ryoono/ding_dong_flash/data/システムモデル.pptx

インターホン子機

インターホン親機

デバイス親機

デバイス子機3

玄関

LED

LED

物理線

ブザー

無線

デバイス子機2

LED

LED

デバイス

デバイス子機1

LED

キッチン

ブザー

間取り

## Slide 2

ピンポンフラッシュ

デバイス子機1
(192.168.1.2)

鳴動処理

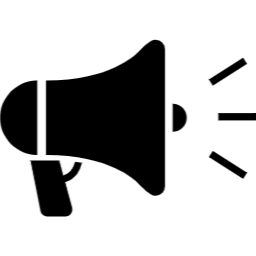
[picture p7: figure]

ブザー

LED

点灯リクエスト

点灯処理

インターホン親機

デバイス親機
(192.168.1.1)

点灯処理

デバイス子機2
(192.168.1.3)

点灯処理

LED

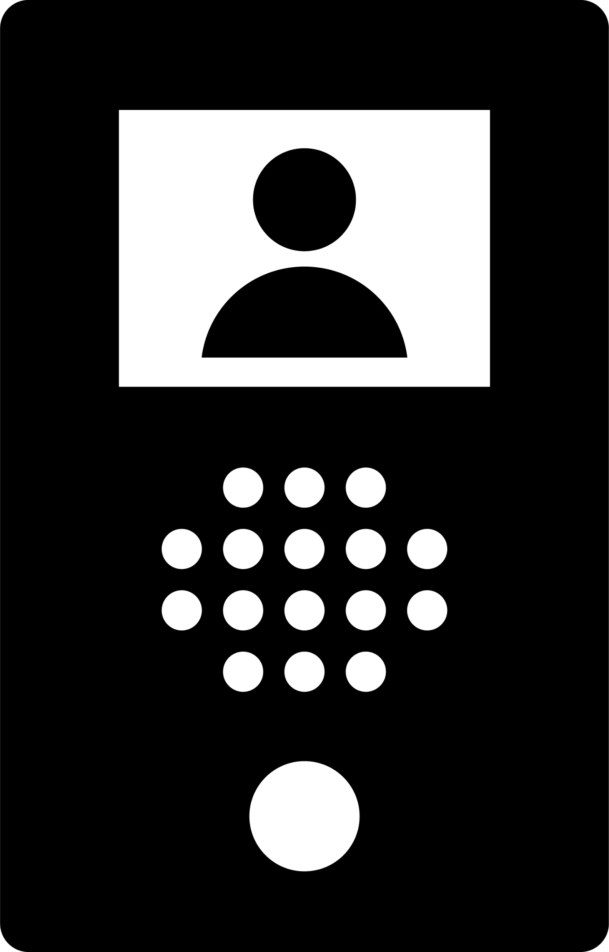
[picture p8: figure]

LED

インターホン子機
押下時にON

インターホン子機
押下判定

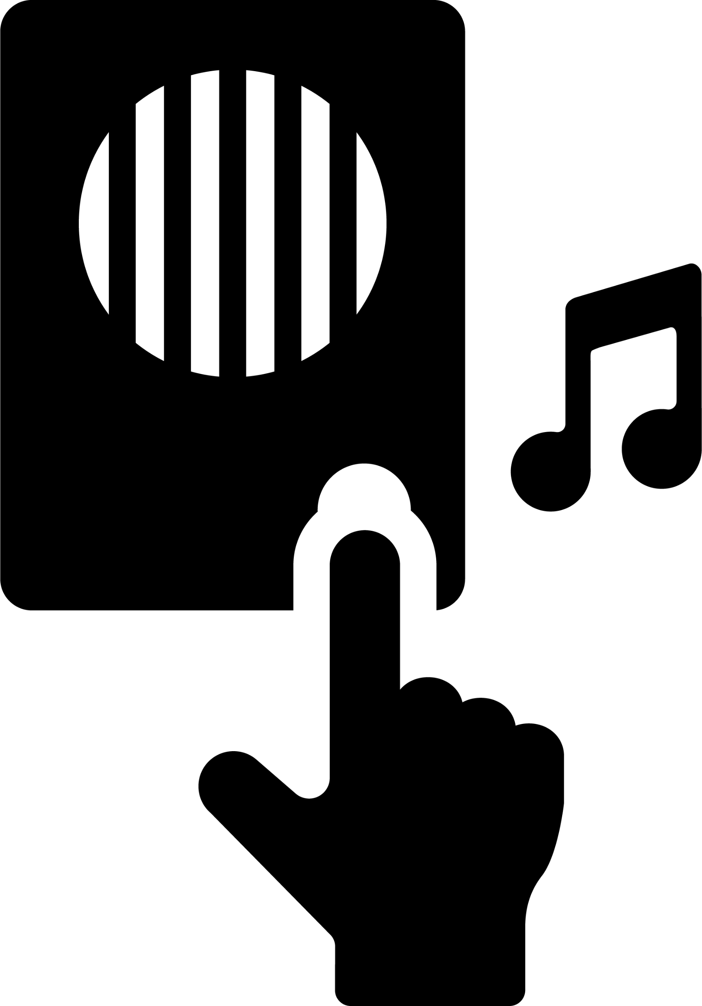
[picture p9: figure]

デバイス子機3
(192.168.1.4)

点灯処理

物理線

LED

インターホン子機

無線
