ryoono/ding_dong_flash/data/実態配線図.png

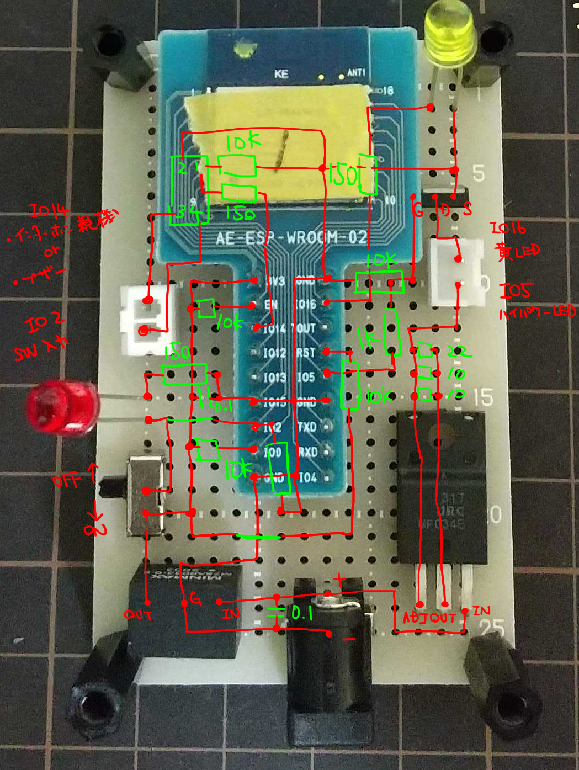
data/実態配線図.png
