ryoono/ding_dong_flash/instruction_manual/ピンポンフラッシュ取扱説明書.docx

ピンポンフラッシュ取扱説明書

# 仕様

本システムは来客を光で通知するシステムであり、インターホン押下のタイミングで一定の間、

ハイパワーLEDを点滅させる。以下の配置で設置することを想定している。

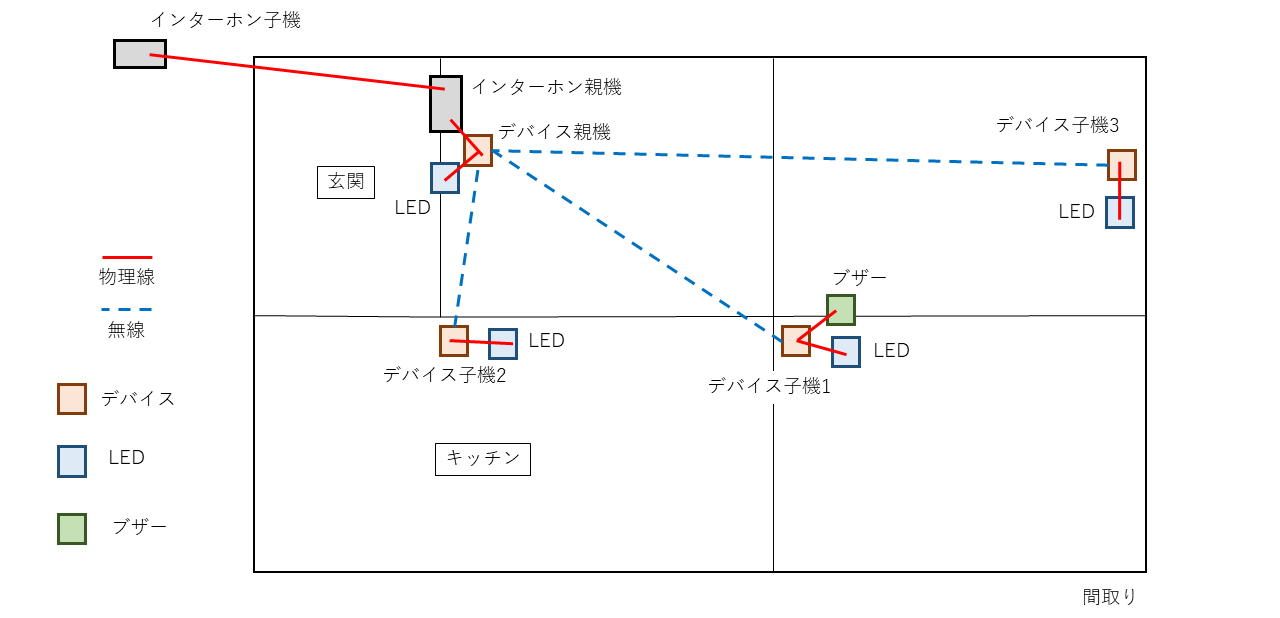
[picture p11: figure]
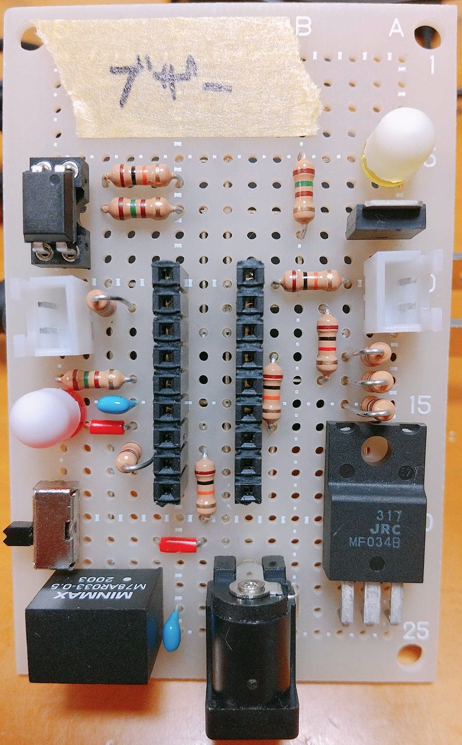
[picture p12: figure]
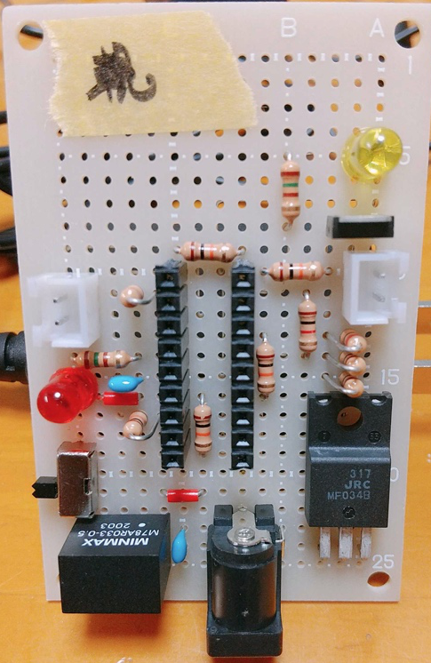
[picture p13: figure]

# 接続方法

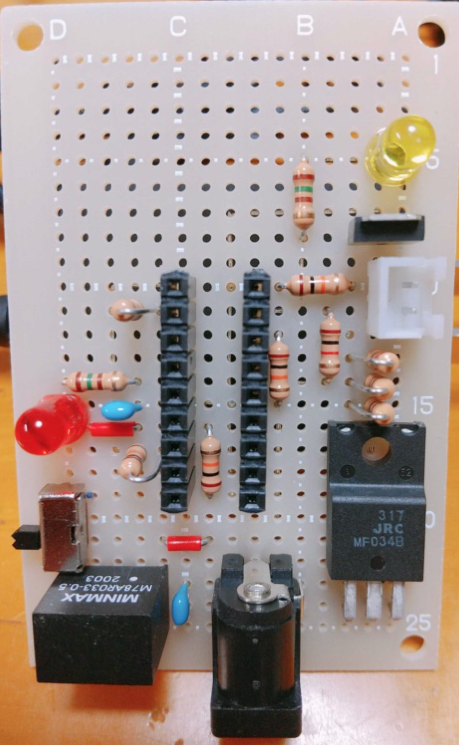
[picture p14: figure]

接続する際は、電源を抜いた状態で行ってください。

左から、「デバイス親機」「デバイス子機1」「デバイス子機2/3」(すべてICを抜いた状態)。

赤枠箇所の端子はインターホン親機のA接点に接続する。

青枠箇所の端子はハイパワーLEDに接続する。

緑枠箇所の端子はブザーに接続する。ブザー側は、下の写真を参考にします。

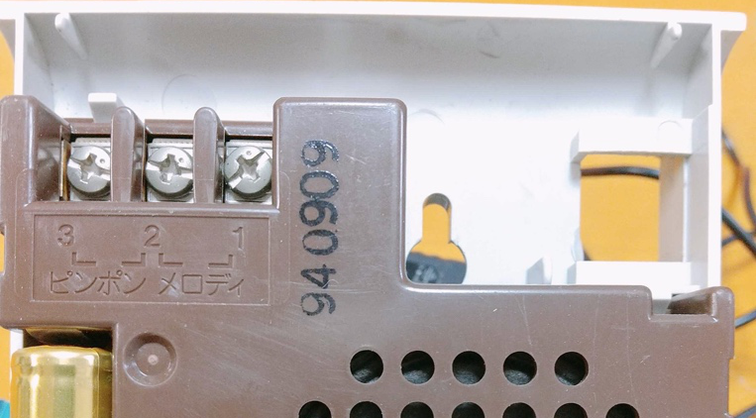
[picture p15: figure]

黒

赤

最後に紫枠箇所の端子に電源を接続する。電源は12V1A/DC(2.1mm標準DCプラグ)を用います。

# 故障かなと思ったら

## Q1：インターホン呼び出し時に、デバイスが光らない、ブザーが鳴らない

LED状態を確認し、電源を遮断した状態で確認事項を試してください。

LED状態 ○/×：点灯/消灯(点滅) | | 確認事項
赤色LED | 黄色LED
○ | ○ | ハイパワーLED、ブザーの接続を確認をしてください。 ブザーの電池残量を確認してください。
○ | × | IC(AE-ESP-WROOM-02)を抜き差ししてください。
× | × | ACアダプタ、電源ケーブルの接続を確認してください。

## Q2：火花が散る、異臭がする

直ちにACアダプタを抜いてください

# テクニカルサポート

オンラインマニュアル

https://github.com/ryoono/ding_dong_flash

何か不明瞭な箇所がありましたら、お気軽にお問い合わせください。
