ryoono/ding_dong_flash/(commit log)

2021-10-15 readmeに概要とネットワーク構成を追記
2021-10-15 ipアドレス修正
2021-10-30 配置図とシステムモデル追加
2021-11-05 leaderDev -> followerDevへの通信成功版
2021-11-06 通信時のポート番号定義
2021-11-07 相互通信成功版
2021-11-10 3台繋げて通信確認成功
2021-11-11 チャタリング対応
2021-11-14 データ送受信仕様変更(子機->親機を無くした) & 状態遷移図追加
2021-11-14 前回コミット分の反映漏れ更新
2021-11-14 .h.sampleファイル追加
2021-11-14 状態遷移図をコードに反映(コンパイルOK)
2021-11-16 idを定数化した
2021-11-16 親機_状態遷移図反映(実機では動かしてない)
2021-11-17 定数定義ファイル分割 & コメントなど微修正
2021-11-18 書き方微修正(処理に変更なし)
2021-11-21 実態配線図追加
2021-11-27 回路図追加
2021-11-28 回路図に注釈追加(ピン番号はデータシート参照)
2021-12-17 実態配線図の画像追加
2021-12-26 製品版のピン番号に変更(コンパイル成功版)
2021-12-31 取扱説明書追加
2021-12-31 README更新(サービスモデルの記載位置変更)
2021-12-31 改行位置更新
2022-01-15 取扱説明書更新
2022-01-15 リンク修正
2022-01-15 取扱説明書リリース版(Ver. A0)
2022-05-04 システム概要写真挿入
